felixmanfredi/SmartSprayer/PCB_Sansevero/HermaTech-main/PCB_Rev1/PCB_3D_1.png

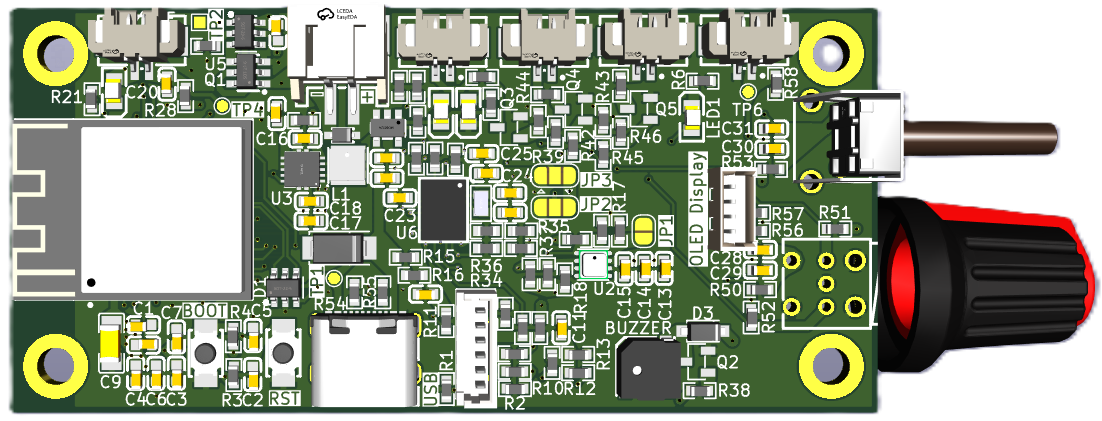
PCB_Sansevero/HermaTech-main/PCB_Rev1/PCB_3D_1.png
