felixmanfredi/SmartSprayer/PCB_Sansevero/HermaTech-main/PCB_Rev1/Anemometer station BOM.xlsx

Descrizione | Quantità | Prezzo c | Link acquisto | Note | Immagine
Anemometro | 1 | 36 | link Amazon (https://www.amazon.it/-/en/gp/product/B086J3R84R/ref=ewc_pr_img_1?smid=AZNIYHVQTVJ7J&psc=1)
ESP32-S3-DevKitC-1 WROOM-1-N16R8 | 1 | 12 | link Amazon (https://www.amazon.it/-/en/ESP-S3-DevKitC-1-WROOM-1-N16R8-Expansion-Development-Bluetooth/dp/B0C6KN35L2) | link Amazon 2 (https://www.amazon.it/-/en/Development-S3-DevKitC-1-WROOM-1-N16R8-Expansion-Compatible/dp/B0DMN5T1GQ)
GPIO expansion board | 1 | 6.15 | link Amazon (https://www.amazon.it/-/en/Joselin-ESP32-S3-Expansion-Breakout-Development/dp/B0D8VKGFWG)
Boost Power Module Battery Charge Protection | 1 | 13 | link Amazon (https://www.amazon.it/-/en/gp/product/B0B9NZ2V5J/ref=ewc_pr_img_1?smid=A3U3NV7MT8POQS&psc=1)
LASER | 1 | 8 | link Amazon (https://www.amazon.it/CESFONJER-Module-Arduino-Raspberry-Prototyping/dp/B07RM3RWSF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)
batteria 1100 mAh | 2 | 10.85 | link Amazon (https://www.amazon.it/Rechargeable-Lithium-Polymer-Battery-Connector/dp/B08FD39Y5R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)
LIDAR TF Luna | 1 | 29 | link Amazon (https://www.amazon.it/youyeetoo-TF-Luna-misurazione-rilevamento-industriale/dp/B088BBJ9SQ)
Lidar VL53L0X | 1 | 4.5 | link Amazon (https://www.amazon.it/-/en/VL53L0X-Distance-GY-VL53L0XV2-Compatible-ARDUINO/dp/B0C3Z4MN6W?s=tools)
