felixmanfredi/SmartSprayer/PCB_Sansevero/HermaTech-main/PCB_Rev1/Knob.step

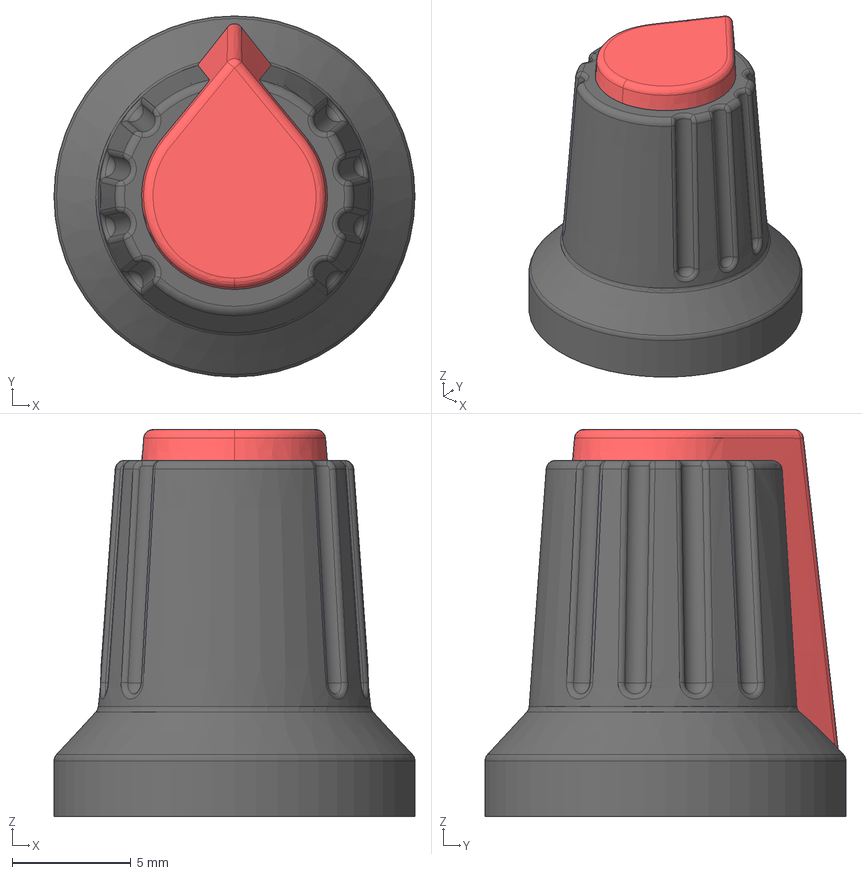
[picture p4: CAD file, 2025-11-18]
PCB_Sansevero/HermaTech-main/PCB_Rev1/Knob.step
15.2 x 15.2 x 16.3 mm
Rouge
Extérieur
