felixmanfredi/SmartSprayer/PCB_Sansevero/HermaTech-main/PCB_Rev1/Schematic_sheets.pdf

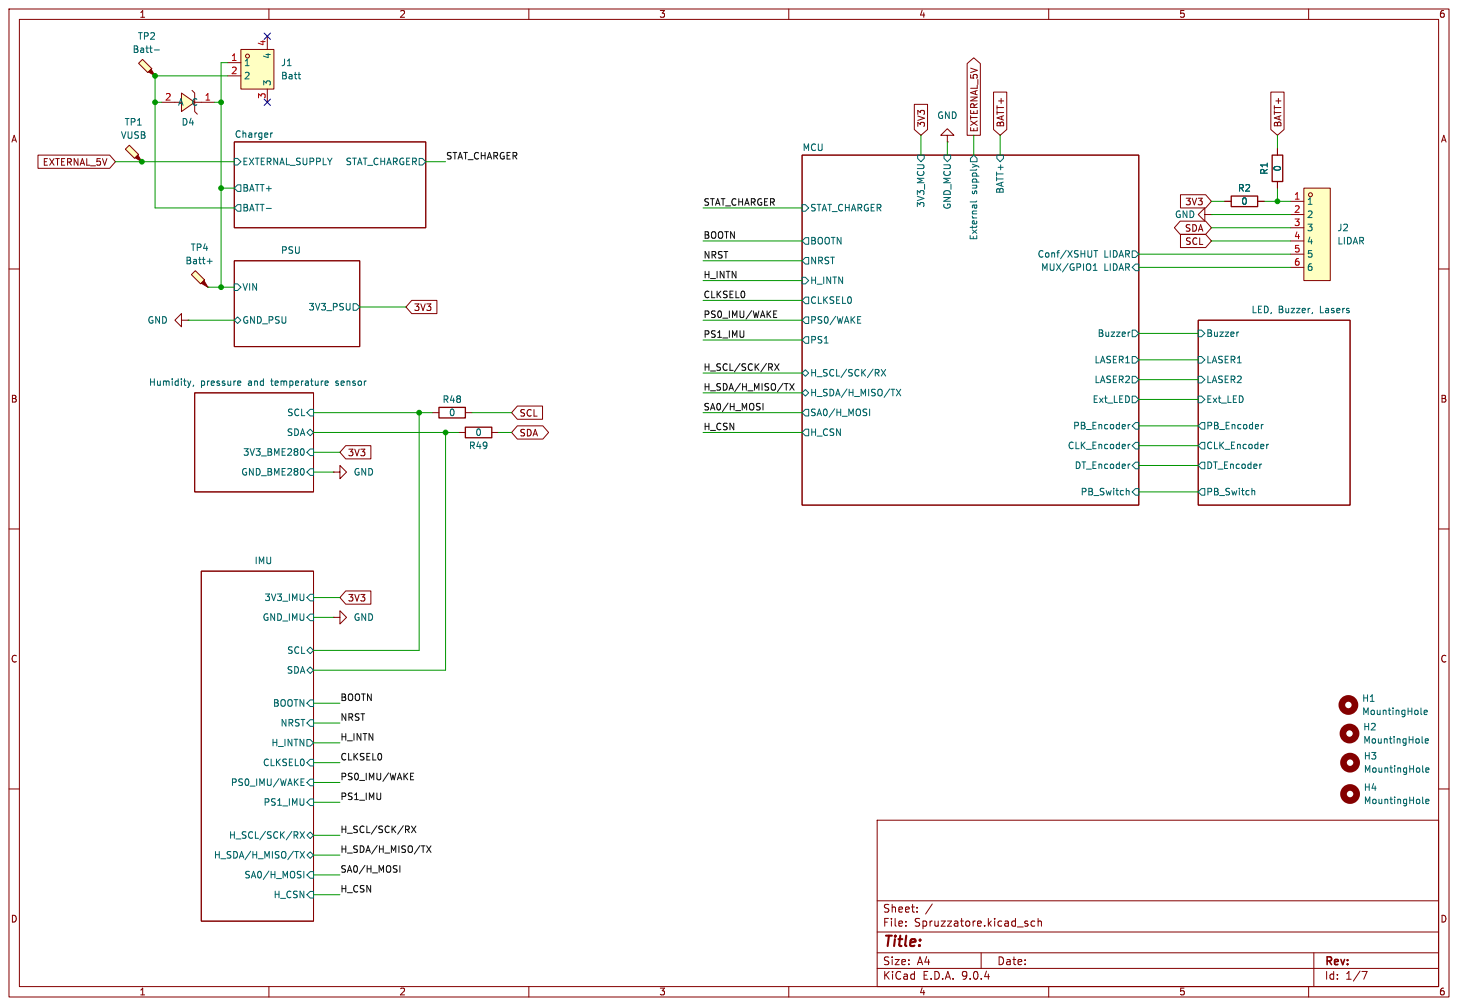
[picture p5: page 1]

IMU
SCL H_SDA/H_MISO/TX CLKSEL0 SA0/H_MOSI H_SCL/SCK/RX H_INTN

Id: 1/7 Title: File: Spruzzatore.kicad_sch Sheet: /

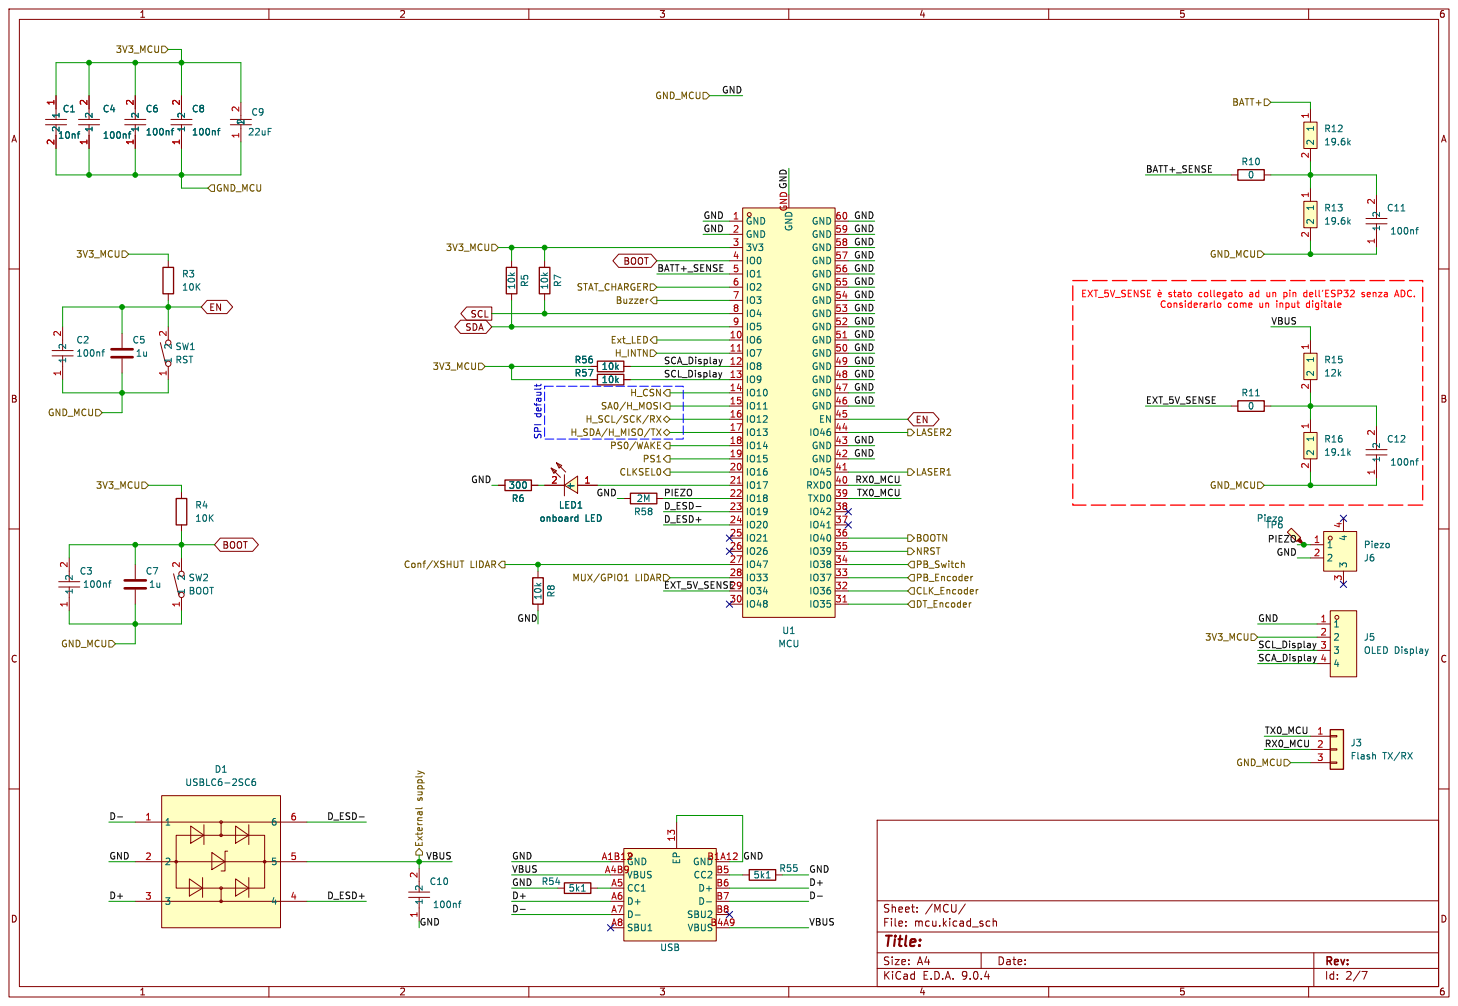
[picture p6: page 2]

Id: 2/7 Title: File: mcu.kicad_sch Sheet: /MCU/

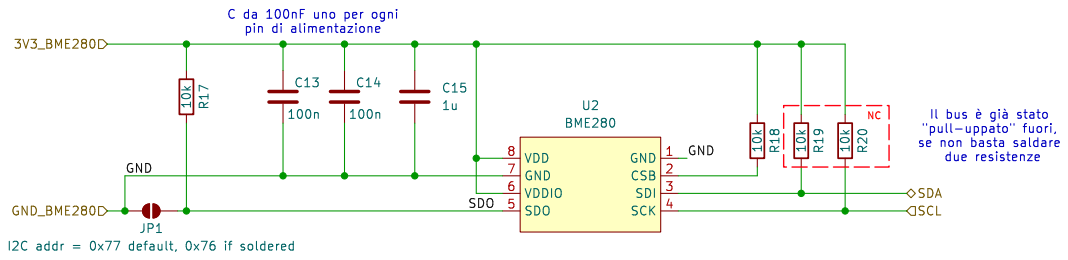
[picture p7: page 3]

C da 100nF uno per ogni

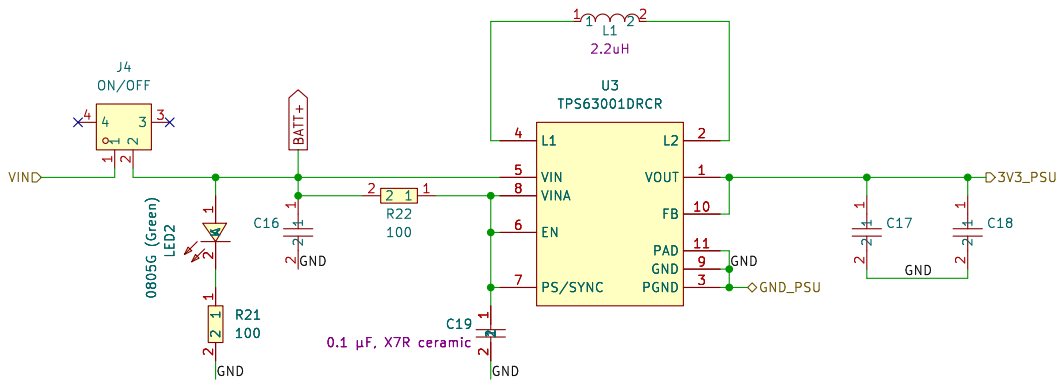
[picture p8: page 4]

Id: 4/7 Title: File: TPS63000_1A_3.3V.kicad_sch Sheet: /PSU/

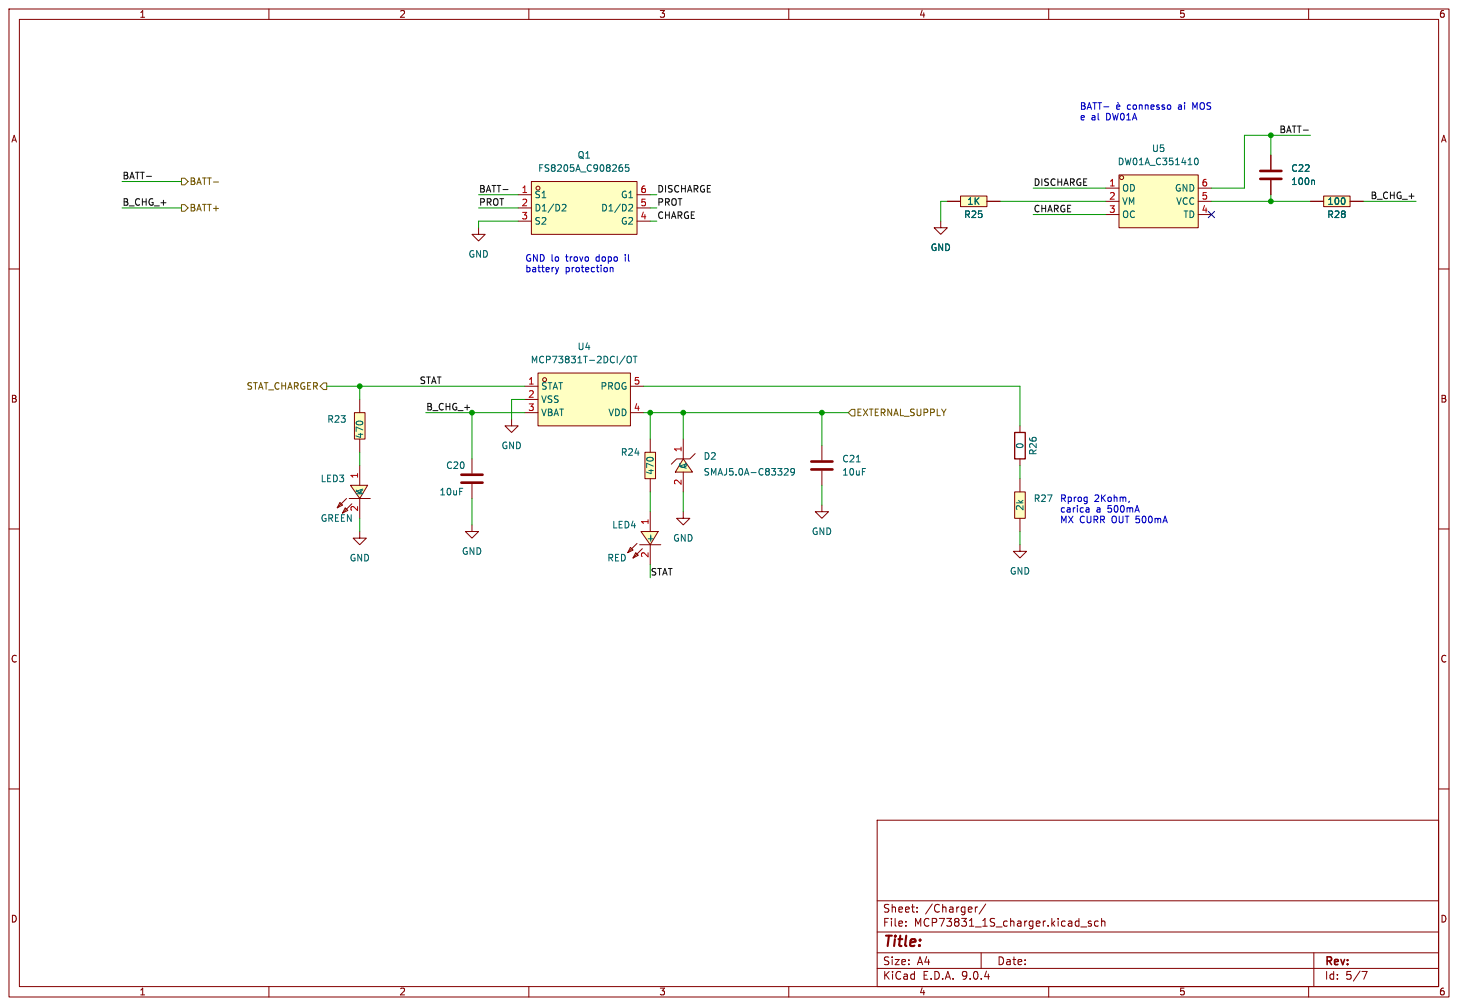
[picture p9: page 5]

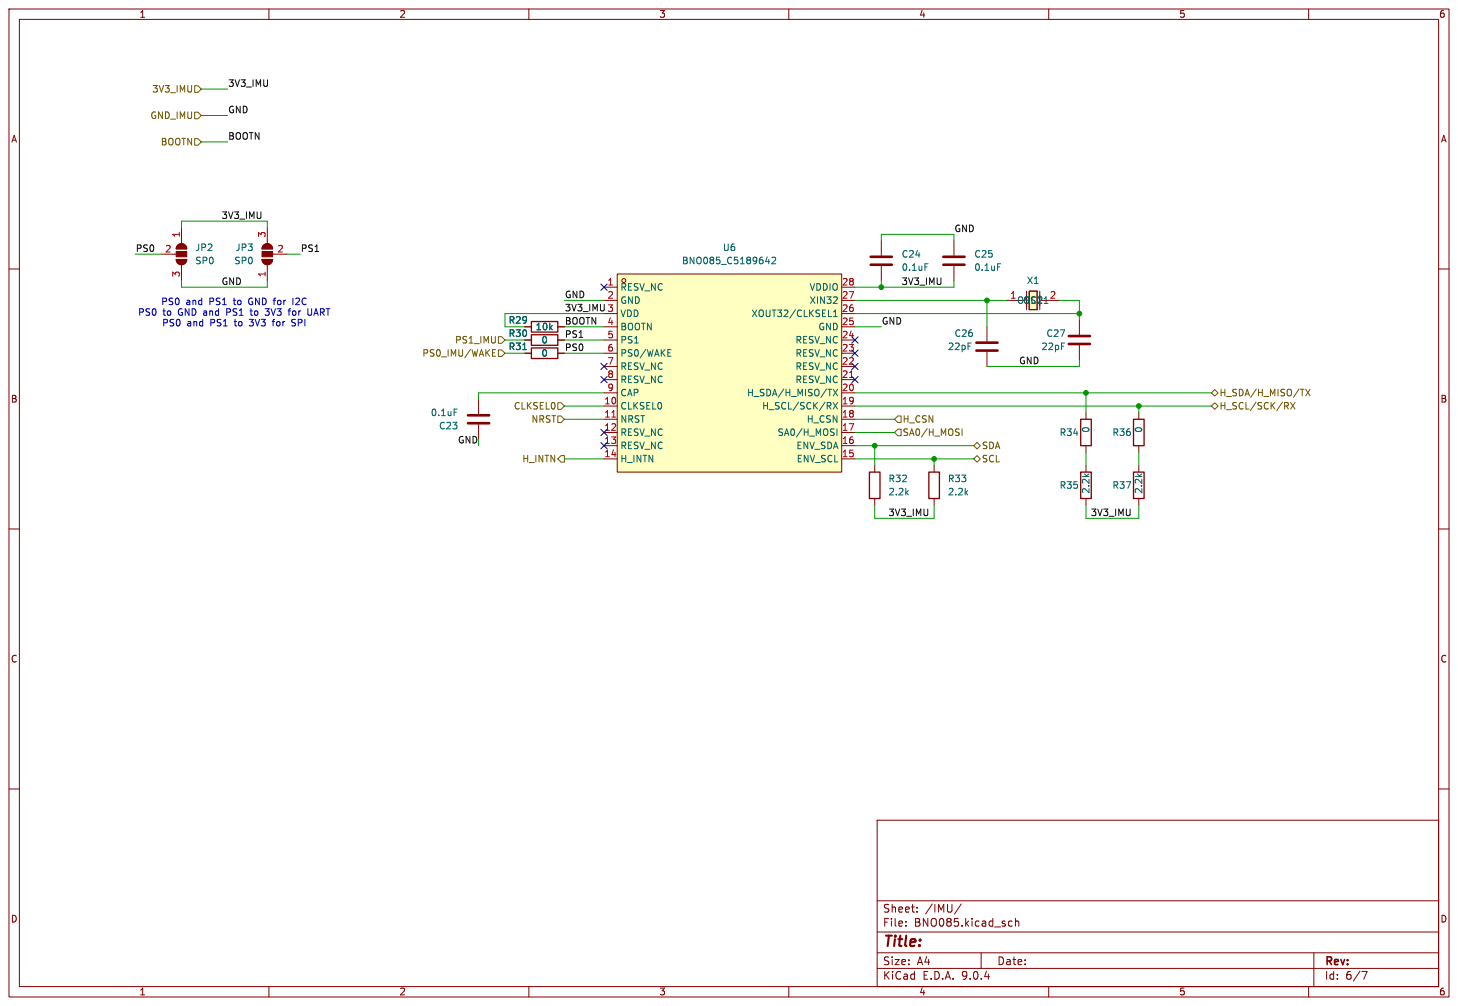
[picture p10: page 6]

PS0 and PS1 to GND for I2C

Id: 6/7 Title: File: BNO085.kicad_sch Sheet: /IMU/

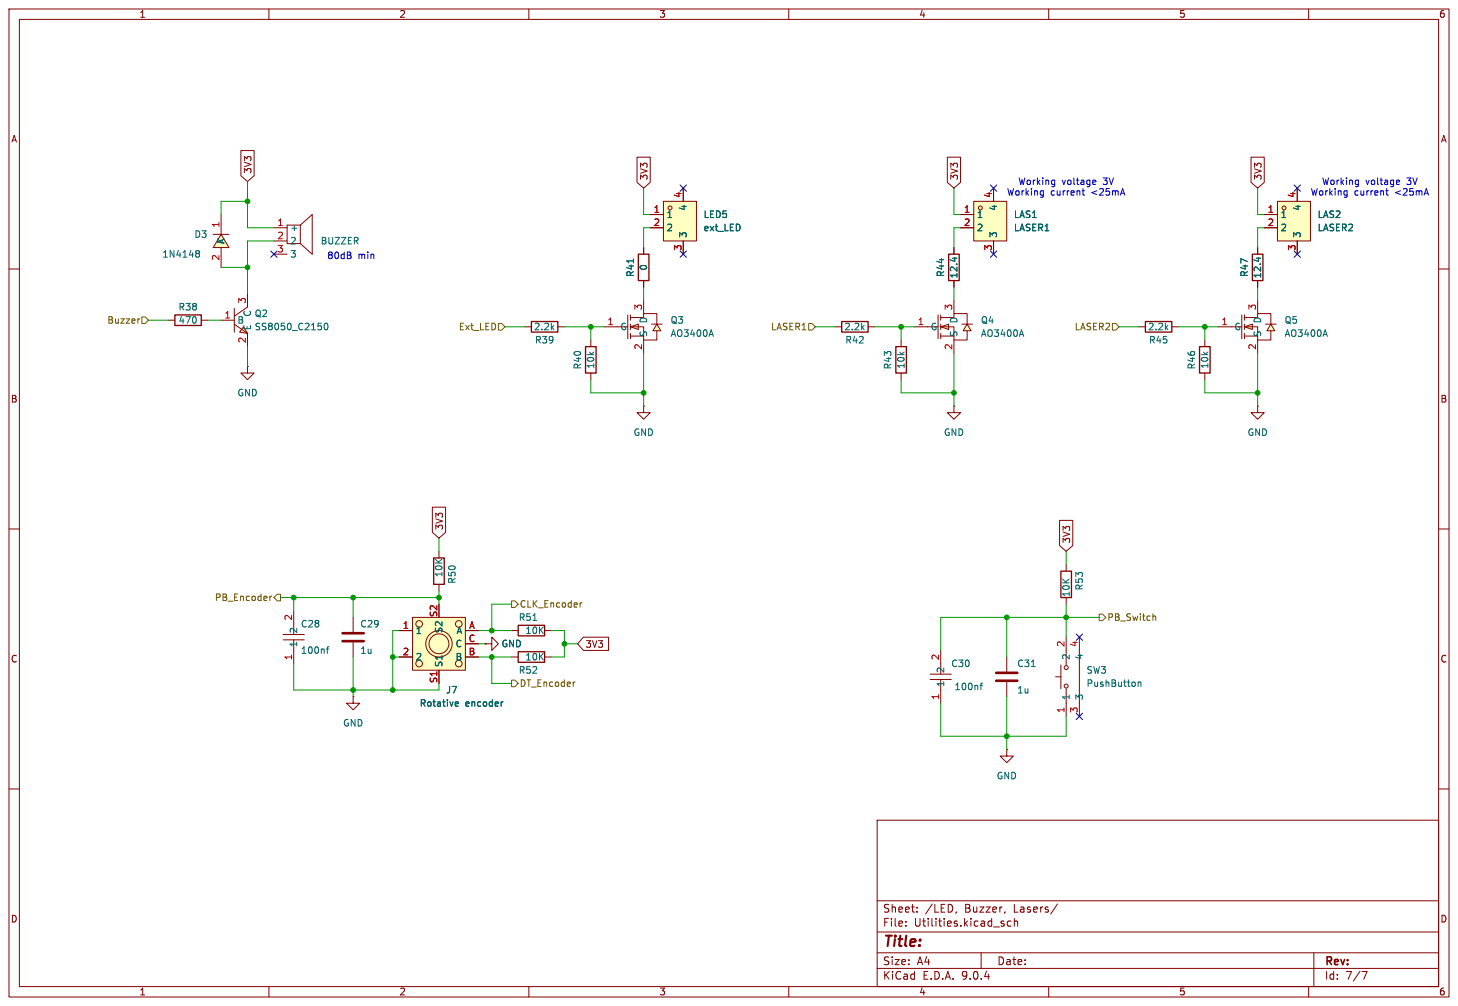
[picture p11: page 7]
