felixmanfredi/SmartSprayer/PCB_Sansevero/HermaTech-main/PCB_Rev1/Spruzzatore.kicad_pcb

## KiCad design PCB_Sansevero/HermaTech-main/PCB_Rev1/Spruzzatore.kicad_pcb (2025-11-18)

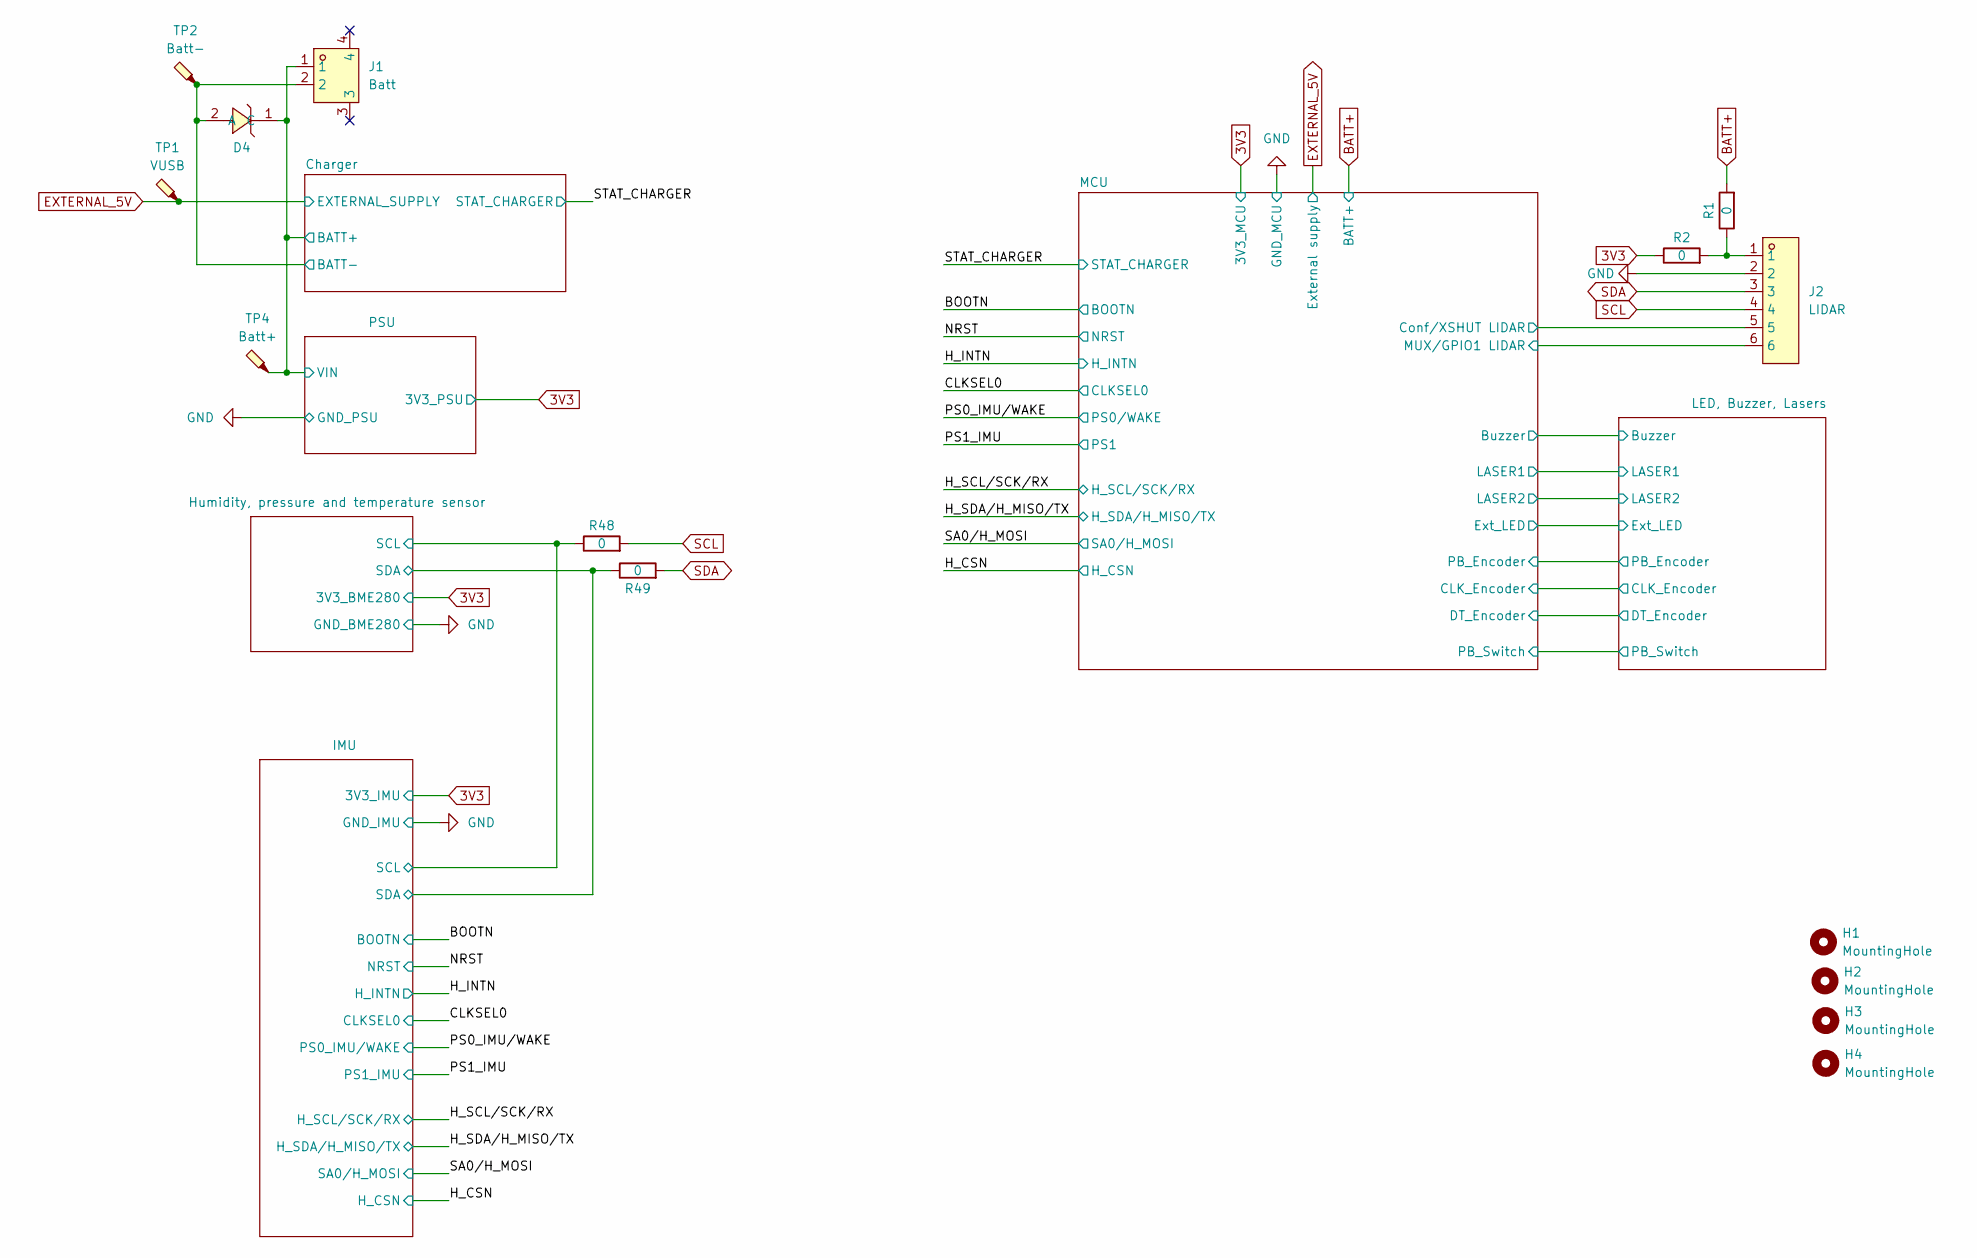
[picture p12: schematic Spruzzatore.kicad_sch]

Parts:
D4: SLESD4V5S; SOD-323_L1.7-W1.3-LS2.6-RD-1; LCSC Part C5155454
H1, H2, H3, H4: MountingHole; MountingHole_3.2mm_M3_DIN965_Pad
J1: Batt; CONN-SMD_P2.00_S2B-PH-SM4-TB-LF-SN; LCSC Part C295747
J2: LIDAR; CONN-TH_6P-P1.25_BX-MX1.25-6PZZ; LCSC Part C22388452
R1, R2, R48, R49: 0; R0603; LCSC Part C21189
TP1: VUSB; TestPoint_Pad_D1.0mm
TP2: Batt-; TestPoint_Pad_1.0x1.0mm
TP4: Batt+; TestPoint_Pad_D1.0mm

Connections:
3V3: R2.1; also elsewhere on the board
/Charger/BATT-: D4.2 (A), J1.2, TP2.1; also elsewhere on the board
/Charger/B_CHG_+: D4.1 (C), J1.1, TP4.1; also elsewhere on the board
/Humidity, pressure and temperature sensor/SCL: R48.1; also elsewhere on the board
/Humidity, pressure and temperature sensor/SDA: R49.1; also elsewhere on the board
/MCU/Conf/XSHUT LIDAR: J2.5; also elsewhere on the board
/MCU/MUX/GPIO1 LIDAR: J2.6; also elsewhere on the board
BATT+: R1.2; also elsewhere on the board
EXTERNAL_5V: TP1.1; also elsewhere on the board
GND: J2.2; also elsewhere on the board
unnamed: J2.1, R1.1, R2.2
SCL: J2.4, R48.2; also elsewhere on the board
SDA: J2.3, R49.2; also elsewhere on the board

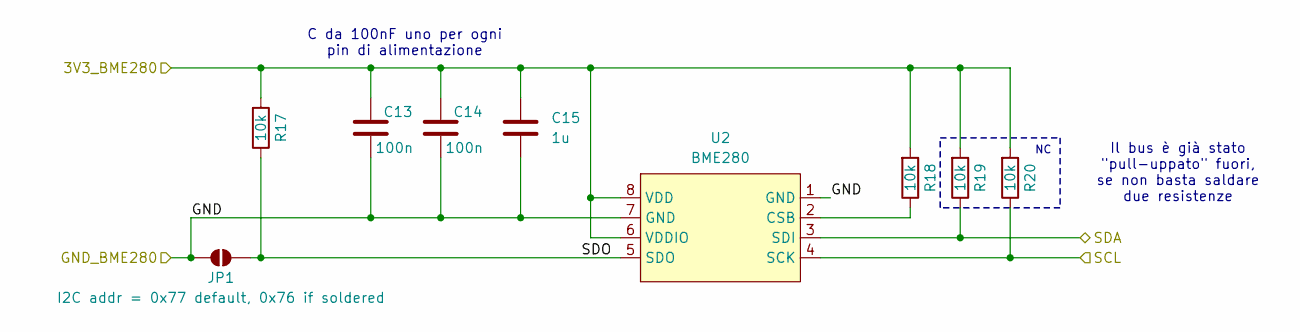
[picture p13: schematic BME280.kicad_sch]

Parts:
C13, C14: 100n; C0603; LCSC Part C14663
C15: 1u; C0603; LCSC Part C15849
JP1: I2C addr = 0x77 default, 0x76 if soldered; SolderJumper-2_P1.3mm_Open_RoundedPad1.0x1.5mm
R17, R18, R19, R20: 10k; R0603; LCSC Part C25804
U2: BME280; LGA-8_BME280_BL; LCSC Part C92489

Connections:
3V3: C13.1, C14.1, C15.1, R17.2, R18.2, R19.2, R20.2, U2.6 (VDDIO), U2.8 (VDD); also elsewhere on the board
/Humidity, pressure and temperature sensor/SCL: R20.1, U2.4 (SCK); also elsewhere on the board
/Humidity, pressure and temperature sensor/SDA: R19.1, U2.3 (SDI); also elsewhere on the board
/Humidity, pressure and temperature sensor/SDO: JP1.1 (A), R17.1, U2.5 (SDO)
GND: C13.2, C14.2, C15.2, JP1.2 (B), U2.1 (GND), U2.7 (GND); also elsewhere on the board
unnamed: R18.1, U2.2 (CSB)

Notes on the sheet:
C da 100nF uno per ogni pin di alimentazione
Il bus è già stato "pull-uppato" fuori, se non basta saldare due resistenze

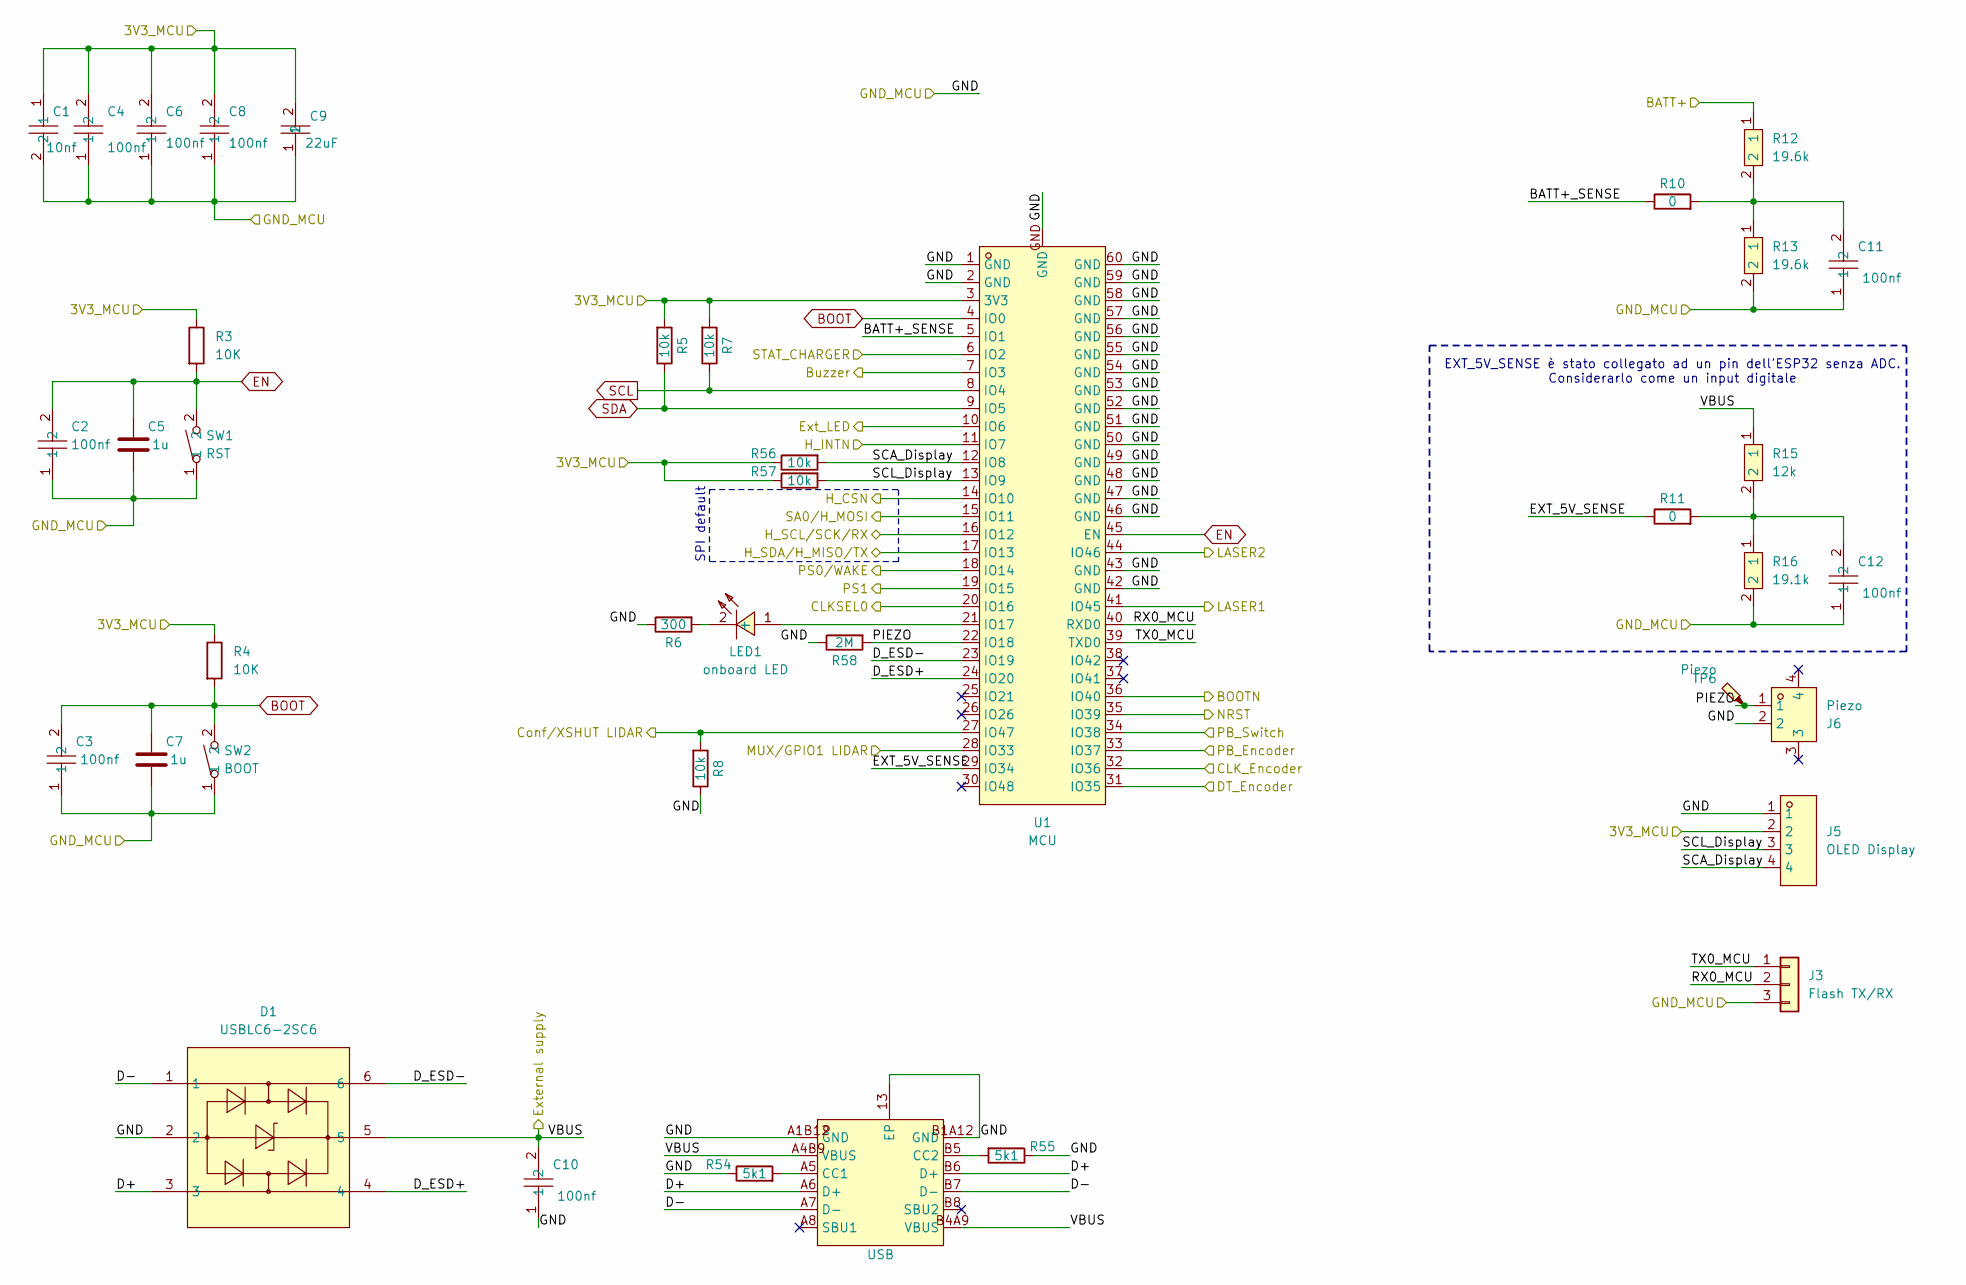
[picture p14: schematic mcu.kicad_sch]

Parts:
C1: 10nf; C0603; LCSC Part C57112
C2, C3, C4, C6, C8, C10, C11, C12: 100nf; C0603; LCSC Part C14663
C5, C7: 1u; C0603; LCSC part C15849
C9: 22uF; C1206; LCSC Part C12891
D1: USBLC6-2SC6; SOT-23-6_L2.9-W1.6-P0.95-LS2.8-BL; LCSC Part C2687116
J3: Flash TX/RX; JST_GH_SM03B-GHS-TB_1x03-1MP_P1.25mm_Horizontal
J5: OLED Display; CONN-TH_4P-P1.25_WAFER-MX1.25-4PZZ; LCSC Part C22390409
J6: Piezo; CONN-SMD_2P-P1.25_XUNPU_WAFER-MX1.25-2PWB; LCSC Part C3029359
LED1: onboard LED; LED0805-R-RD; LCSC Part C84256
R3, R4: 10K; R0603; LCSC Part C25804
R5, R7, R56, R57: 10k; R0603; LCSC Part C25804
R6: 300; R0603; LCSC Part C23025
R8: 10k; R0603
R10, R11: 0; R0603; LCSC Part C21189
R12, R13: 19.6k; R0603; LCSC Part C861185
R15: 12k; R0603; LCSC Part C861185
R16: 19.1k; R0603; LCSC Part C861097
R54, R55: 5k1; R0603; LCSC C23186
R58: 2M; R0603; LCSC Part C23025
SW1: RST; SW-SMD_L3.9-W2.9-P4.15-LS5.0; LCSC Part C493285
SW2: BOOT; SW-SMD_L3.9-W2.9-P4.15-LS5.0; LCSC Part C493285
TP6: Piezo; TestPoint_Pad_D1.0mm
U1: MCU; BULETM-SMD_ESP32-S3-MINI-1-N8; LCSC Part C3013941
USB1: USB; USB-C-SMD_TYPE-C-16P-1; LCSC Part C2982555

Connections:
3V3: C1.1, C4.2, C6.2, C8.2, C9.2, J5.2, R3.1, R4.1, R5.2, R7.2, R56.1, R57.1, U1.3 (3V3); also elsewhere on the board
/BOOTN: U1.36 (IO40); also elsewhere on the board
/CLKSEL0: U1.20 (IO16); also elsewhere on the board
/H_CSN: U1.14 (IO10); also elsewhere on the board
/H_INTN: U1.11 (IO7); also elsewhere on the board
/H_SCL/SCK/RX: U1.16 (IO12); also elsewhere on the board
/H_SDA/H_MISO/TX: U1.17 (IO13); also elsewhere on the board
/LED, Buzzer, Lasers/Buzzer: U1.7 (IO3); also elsewhere on the board
/LED, Buzzer, Lasers/CLK_Encoder: U1.32 (IO36); also elsewhere on the board
/LED, Buzzer, Lasers/DT_Encoder: U1.31 (IO35); also elsewhere on the board
/LED, Buzzer, Lasers/Ext_LED: U1.10 (IO6); also elsewhere on the board
/LED, Buzzer, Lasers/LASER1: U1.41 (IO45); also elsewhere on the board
/LED, Buzzer, Lasers/LASER2: U1.44 (IO46); also elsewhere on the board
/LED, Buzzer, Lasers/PB_Encoder: U1.33 (IO37); also elsewhere on the board
/LED, Buzzer, Lasers/PB_Switch: U1.34 (IO38); also elsewhere on the board
/MCU/BATT+_SENSE: R10.1, U1.5 (IO1)
/MCU/Conf/XSHUT LIDAR: R8.2, U1.27 (IO47); also elsewhere on the board
/MCU/D+: D1.3, USB1.A6 (D+), USB1.B6 (D+)
/MCU/D-: D1.1, USB1.A7 (D-), USB1.B7 (D-)
/MCU/D_ESD+: D1.4, U1.24 (IO20)
/MCU/D_ESD-: D1.6, U1.23 (IO19)
/MCU/EXT_5V_SENSE: R11.1, U1.29 (IO34)
/MCU/MUX/GPIO1 LIDAR: U1.28 (IO33); also elsewhere on the board
/MCU/PIEZO: J6.1, R58.2, TP6.1, U1.22 (IO18)
/MCU/RX0_MCU: J3.2, U1.40 (RXD0)
/MCU/SCA_Display: J5.4, R56.2, U1.12 (IO8)
/MCU/SCL_Display: J5.3, R57.2, U1.13 (IO9)
/MCU/TX0_MCU: J3.1, U1.39 (TXD0)
/NRST: U1.35 (IO39); also elsewhere on the board
/PS0_IMU/WAKE: U1.18 (IO14); also elsewhere on the board
/PS1_IMU: U1.19 (IO15); also elsewhere on the board
/SA0/H_MOSI: U1.15 (IO11); also elsewhere on the board
/STAT_CHARGER: U1.6 (IO2); also elsewhere on the board
BATT+: R12.1; also elsewhere on the board
BOOT: C3.2, C7.1, R4.2, SW2.2, U1.4 (IO0)
EN: C2.2, C5.1, R3.2, SW1.2, U1.45 (EN)
EXTERNAL_5V: C10.2, D1.5, R15.1, USB1.A4B9 (VBUS), USB1.B4A9 (VBUS); also elsewhere on the board
GND: C1.2, C2.1, C3.1, C4.1, C5.2, C6.1, C7.2, C8.1, C9.1, C10.1, C11.1, C12.1, D1.2, J3.3, J5.1, J6.2, R6.1, R8.1, R13.2, R16.2, R54.1, R55.1, R58.1, SW1.1, SW2.1, U1.1 (GND), U1.2 (GND), U1.42 (GND), U1.43 (GND), U1.46 (GND), U1.47 (GND), U1.48 (GND), U1.49 (GND), U1.50 (GND), U1.51 (GND), U1.52 (GND), U1.53 (GND), U1.54 (GND), U1.55 (GND), U1.56 (GND), U1.57 (GND), U1.58 (GND), U1.59 (GND), U1.60 (GND), U1.GND, USB1.13 (EP), USB1.A1B12 (GND), USB1.B1A12 (GND); also elsewhere on the board
unnamed: C11.2, R10.2, R12.2, R13.1
unnamed: C12.2, R11.2, R15.2, R16.1
unnamed: LED1.1 (+), U1.21 (IO17)
unnamed: LED1.2 (-), R6.2
unnamed: R54.2, USB1.A5 (CC1)
unnamed: R55.2, USB1.B5 (CC2)
SCL: R7.1, U1.8 (IO4); also elsewhere on the board
SDA: R5.1, U1.9 (IO5); also elsewhere on the board

Notes on the sheet:
SPI default
EXT_5V_SENSE è stato collegato ad un pin dell'ESP32 senza ADC. Considerarlo come un input digitale

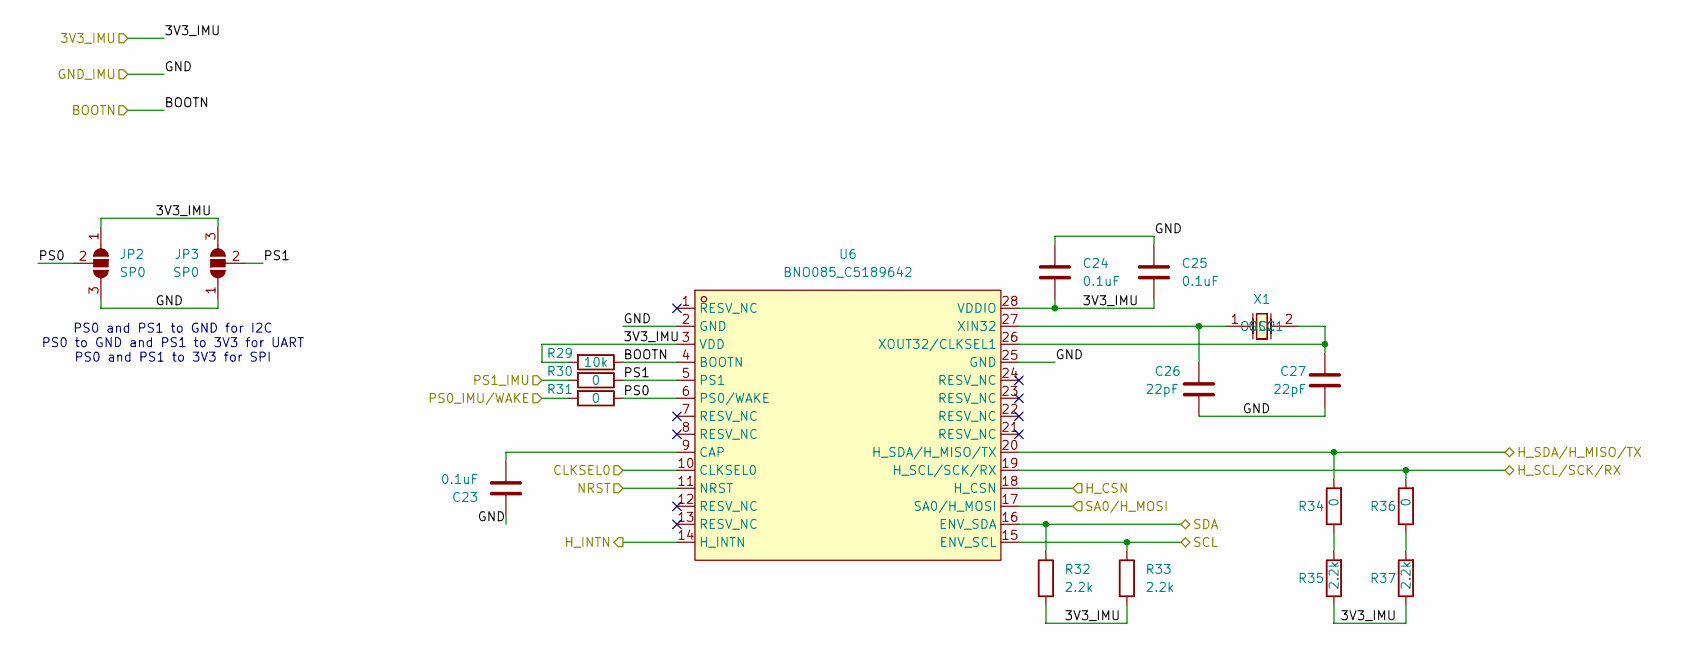
[picture p15: schematic BNO085.kicad_sch]

Parts:
C23, C24, C25: 0.1uF; C0603
C26, C27: 22pF; C0603
JP2, JP3: SP0; SolderJumper-3_P1.3mm_Open_RoundedPad1.0x1.5mm
R29: 10k; R0603; LCSC Part C21189
R30, R31: 0; R0603; LCSC Part C21189
R32, R33, R35, R37: 2.2k; R0603
R34, R36: 0; R0603
U6: BNO085_C5189642; LGA-28_L5.2-W3.8-P0.50-BL; LCSC Part C5189642
X1: ABS06-32.768KHZ-T; OSC-SMD_L2.0-W1.2; LCSC Part C276423

Connections:
3V3: C24.2, C25.2, JP2.1 (A), JP3.3 (B), R29.2, R32.2, R33.2, R35.1, R37.1, U6.3 (VDD), U6.28 (VDDIO); also elsewhere on the board
/BOOTN: R29.1, U6.4 (BOOTN); also elsewhere on the board
/CLKSEL0: U6.10 (CLKSEL0); also elsewhere on the board
/H_CSN: U6.18 (H_CSN); also elsewhere on the board
/H_INTN: U6.14 (H_INTN); also elsewhere on the board
/H_SCL/SCK/RX: R36.2, U6.19 (H_SCL/SCK/RX); also elsewhere on the board
/H_SDA/H_MISO/TX: R34.2, U6.20 (H_SDA/H_MISO/TX); also elsewhere on the board
/Humidity, pressure and temperature sensor/SCL: R33.1, U6.15 (ENV_SCL); also elsewhere on the board
/Humidity, pressure and temperature sensor/SDA: R32.1, U6.16 (ENV_SDA); also elsewhere on the board
/IMU/PS0: JP2.2 (C), R31.1, U6.6 (PS0/WAKE)
/IMU/PS1: JP3.2 (C), R30.1, U6.5 (PS1)
/NRST: U6.11 (NRST); also elsewhere on the board
/PS0_IMU/WAKE: R31.2; also elsewhere on the board
/PS1_IMU: R30.2; also elsewhere on the board
/SA0/H_MOSI: U6.17 (SA0/H_MOSI); also elsewhere on the board
GND: C23.1, C24.1, C25.1, C26.1, C27.1, JP2.3 (B), JP3.1 (A), U6.2 (GND), U6.25 (GND); also elsewhere on the board
unnamed: R34.1, R35.2
unnamed: R36.1, R37.2
unnamed: C23.2, U6.9 (CAP)
unnamed: C26.2, U6.27 (XIN32), X1.1 (OSC1)
unnamed: C27.2, U6.26 (XOUT32/CLKSEL1), X1.2 (OSC2)

Notes on the sheet:
PS0 and PS1 to GND for I2C PS0 to GND and PS1 to 3V3 for UART PS0 and PS1 to 3V3 for SPI

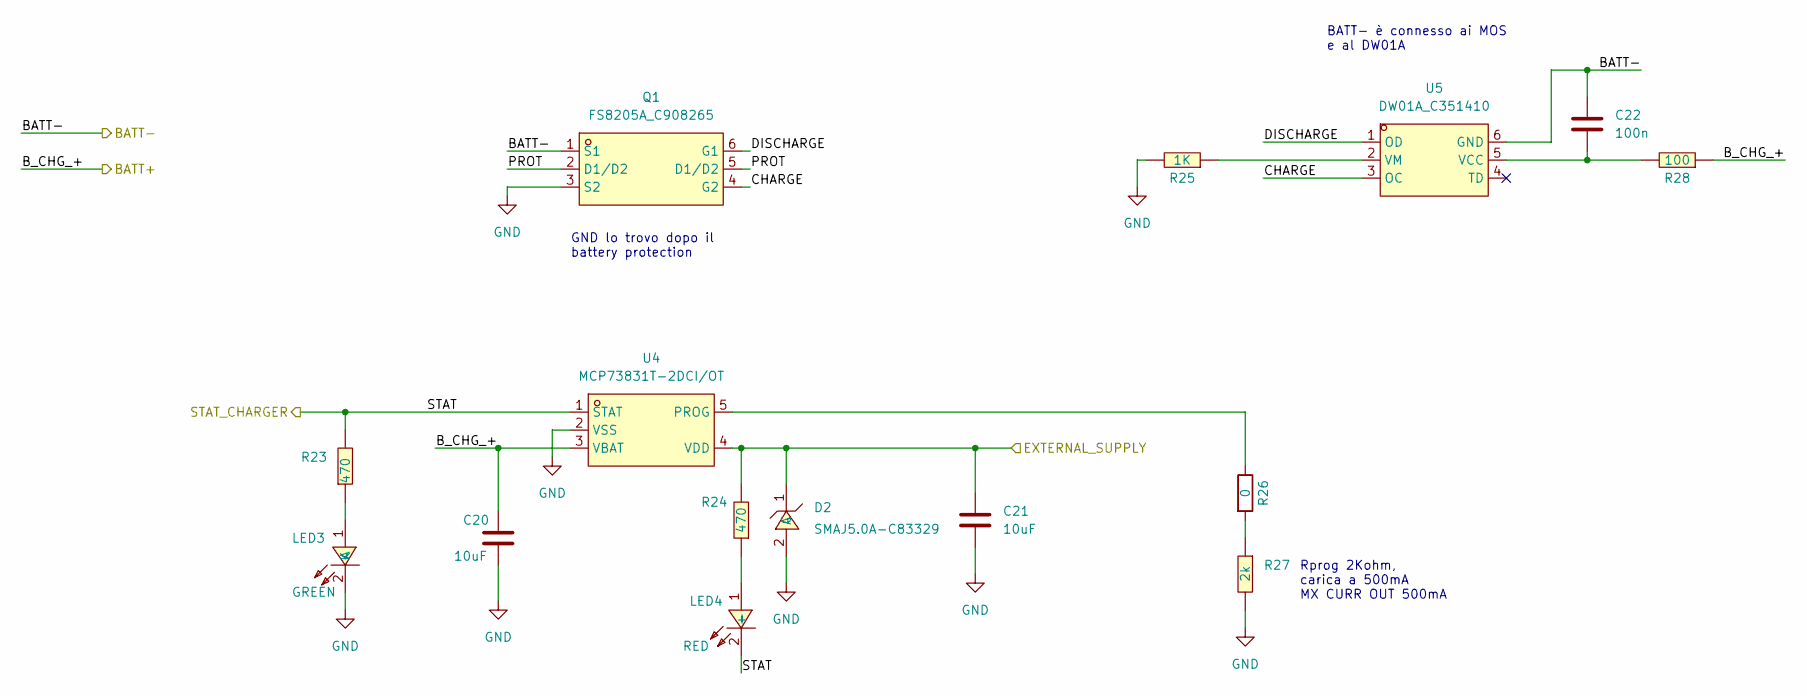
[picture p16: schematic MCP73831_1S_charger.kicad_sch]

Parts:
C20, C21: 10uF; C0603
C22: 100n; C0603
D2: SMAJ5.0A-C83329; SMA_L4.3-W2.6-LS5.2-RD; LCSC Part C83329
LED3: GREEN; LED0805-R-RD; LCSC Part C2297
LED4: RED; LED0805-R-RD; LCSC Part C84256
Q1: FS8205A_C908265; SOT-23-6_L2.9-W1.6-P0.95-LS2.8-BR; LCSC Part C908265
R23, R24: 470; R0603
R25: 1K; R0603
R26: 0; R0603; LCSC Part C21189
R27: 2k; R0603
R28: 100; R0603
U4: MCP73831T-2DCI/OT; SOT-23-5_L2.9-W1.6-P0.95-LS2.8-BL; LCSC Part C625597
U5: DW01A_C351410; SOT-23-6_L2.9-W1.6-P0.95-LS2.8-BL; LCSC Part C351410

Connections:
/Charger/BATT-: C22.1, Q1.1 (S1), U5.6 (GND); also elsewhere on the board
/Charger/B_CHG_+: C20.1, R28.1, U4.3 (VBAT); also elsewhere on the board
/Charger/CHARGE: Q1.4 (G2), U5.3 (OC)
/Charger/DISCHARGE: Q1.6 (G1), U5.1 (OD)
/Charger/PROT: Q1.2 (D1/D2), Q1.5 (D1/D2)
/STAT_CHARGER: LED4.2 (-), R23.2, U4.1 (STAT); also elsewhere on the board
EXTERNAL_5V: C21.1, D2.1 (C), R24.2, U4.4 (VDD); also elsewhere on the board
GND: C20.2, C21.2, D2.2 (A), LED3.2 (K), Q1.3 (S2), R25.2, R27.2, U4.2 (VSS); also elsewhere on the board
unnamed: LED3.1 (A), R23.1
unnamed: LED4.1 (+), R24.1
unnamed: R26.2, R27.1
unnamed: R26.1, U4.5 (PROG)
unnamed: C22.2, R28.2, U5.5 (VCC)
unnamed: R25.1, U5.2 (VM)

Notes on the sheet:
Rprog 2Kohm, carica a 500mA MX CURR OUT 500mA
GND lo trovo dopo il battery protection
BATT- è connesso ai MOS e al DW01A

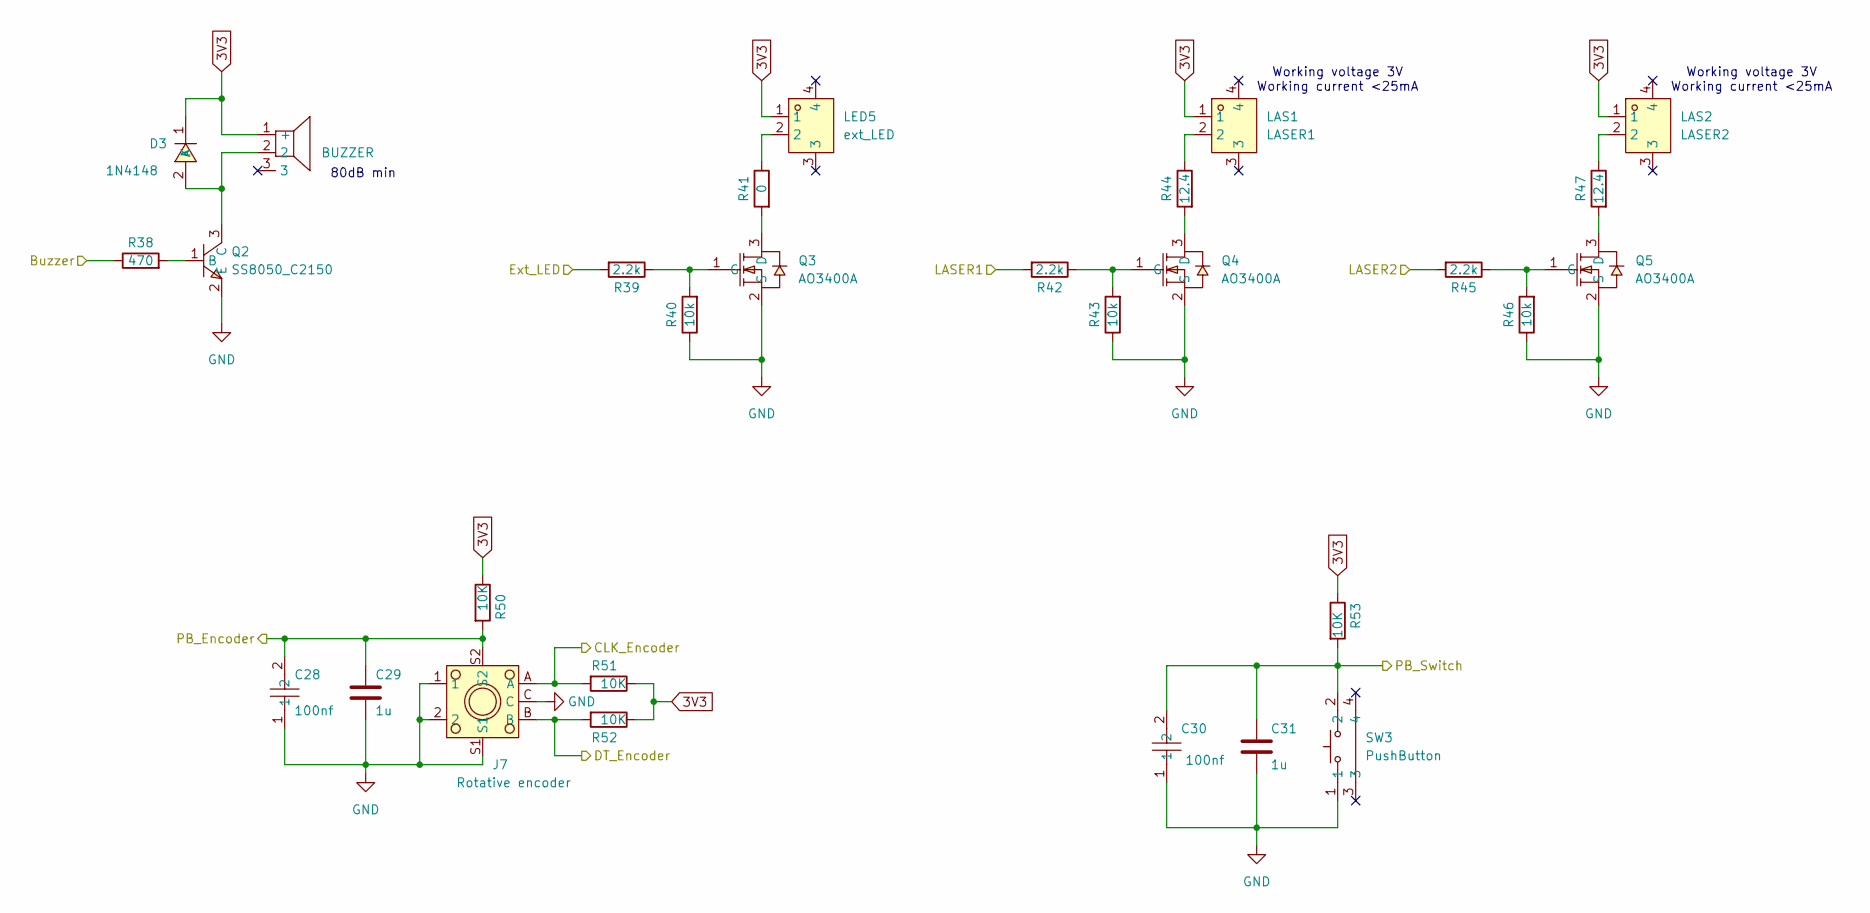
[picture p17: schematic Utilities.kicad_sch]

Parts:
BUZZER1: BUZZER; BUZ-SMD_FST-5025; LCSC Part C391030
C28, C30: 100nf; C0603; LCSC Part C14663
C29, C31: 1u; C0603; LCSC part C15849
D3: 1N4148; SOD-123F_L2.7-W1.6-LS3.8-RD; LCSC Part C81598
J7: Rotative encoder; SW-TH_CTR_ED08905M-FE15C7.0-C10-2053; LCSC Part C18213469
LAS1: LASER1; CONN-SMD_2P-P1.25_XUNPU_WAFER-MX1.25-2PWB; LCSC Part C3029359
LAS2: LASER2; CONN-SMD_2P-P1.25_XUNPU_WAFER-MX1.25-2PWB; LCSC Part C3029359
LED5: ext_LED; CONN-SMD_2P-P1.25_XUNPU_WAFER-MX1.25-2PWB; LCSC Part C3029359
Q2: SS8050_C2150; SOT-23-3_L2.9-W1.3-P1.90-LS2.4-BR; LCSC Part C2150
Q3, Q4, Q5: AO3400A; SOT-23-3_L2.9-W1.3-P1.90-LS2.4-BR; LCSC Part C20917
R38: 470; R0603; LCSC C441919
R39, R42, R45: 2.2k; R0603; LCSC Part C4190
R40, R43, R46: 10k; R0603; LCSC Part C25804
R41: 0; R0603; LCSC Part C17888
R44, R47: 12.4; R0603; LCSC Part C22786
R50, R51, R52, R53: 10K; R0603; LCSC Part C25804
SW3: PushButton; SW-TH_SKHHNJA010; LCSC Part C470264

Connections:
3V3: BUZZER1.1 (+), D3.1 (K), LAS1.1, LAS2.1, LED5.1, R50.1, R51.1, R52.1, R53.1; also elsewhere on the board
/LED, Buzzer, Lasers/Buzzer: R38.1; also elsewhere on the board
/LED, Buzzer, Lasers/CLK_Encoder: J7.A, R51.2; also elsewhere on the board
/LED, Buzzer, Lasers/DT_Encoder: J7.B, R52.2; also elsewhere on the board
/LED, Buzzer, Lasers/Ext_LED: R39.2; also elsewhere on the board
/LED, Buzzer, Lasers/LASER1: R42.2; also elsewhere on the board
/LED, Buzzer, Lasers/LASER2: R45.2; also elsewhere on the board
/LED, Buzzer, Lasers/PB_Encoder: C28.2, C29.1, J7.S2, R50.2; also elsewhere on the board
/LED, Buzzer, Lasers/PB_Switch: C30.2, C31.1, R53.2, SW3.2; also elsewhere on the board
GND: C28.1, C29.2, C30.1, C31.2, J7.1, J7.2, J7.C, J7.S1, Q2.2 (E), Q3.2 (S), Q4.2 (S), Q5.2 (S), R40.1, R43.1, R46.1, SW3.1; also elsewhere on the board
unnamed: BUZZER1.2, D3.2 (A), Q2.3 (C)
unnamed: LAS1.2, R44.1
unnamed: LAS2.2, R47.1
unnamed: LED5.2, R41.1
unnamed: Q2.1 (B), R38.2
unnamed: Q3.3 (D), R41.2
unnamed: Q3.1 (G), R39.1, R40.2
unnamed: Q4.3 (D), R44.2
unnamed: Q4.1 (G), R42.1, R43.2
unnamed: Q5.3 (D), R47.2
unnamed: Q5.1 (G), R45.1, R46.2

Notes on the sheet:
Working voltage 3V Working current <25mA
80dB min

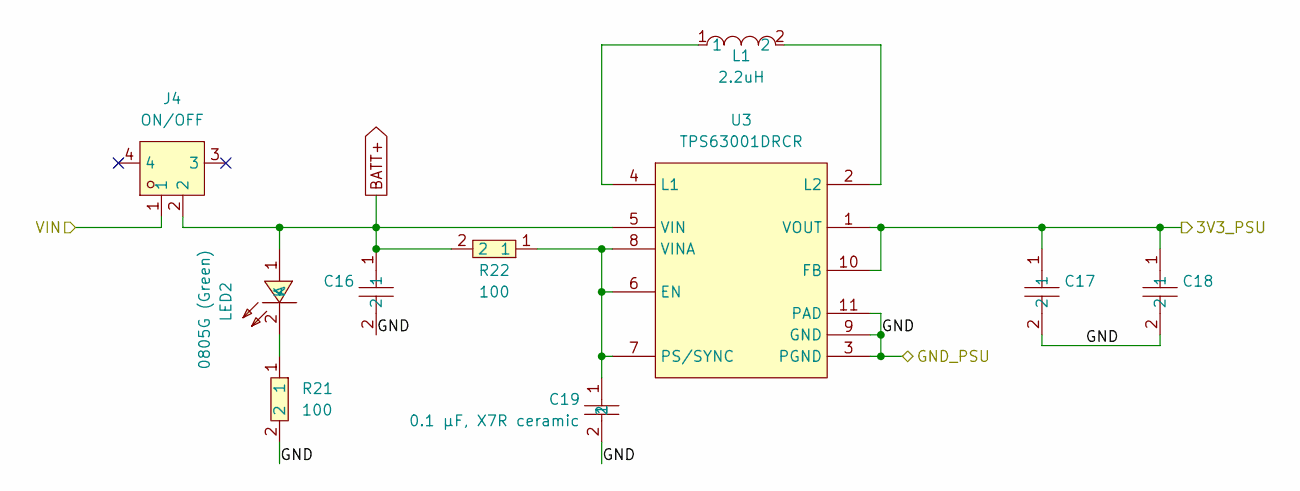
[picture p18: schematic TPS63000_1A_3.3V.kicad_sch]

Parts:
C16, C17, C18: CL10B106MQ8NRNC; C0603; LCSC Part C3039698
C19: CL10B104KA8NNNC; C0603; LCSC Part C1590
J4: ON/OFF; CONN-SMD_2P-P1.25_XUNPU_WAFER-MX1.25-2PWB; LCSC Part C3029359
L1: LQH3NPN2R2MMEL; IND-SMD_L3.0-W3.0_LQH3NPN2R2NG0L; LCSC Part C668451
LED2: 0805G (Green); LED0805-R-RD; LCSC Part C2297
R21, R22: 100; R0603; LCSC Part C22775
U3: TPS63001DRCR; VSON-10_L3.0-W3.0-P0.50-TL-EP_TPS62410DRCR; LCSC Part C28060

Connections:
3V3: C17.1, C18.1, U3.1 (VOUT), U3.10 (FB); also elsewhere on the board
/Charger/B_CHG_+: J4.1; also elsewhere on the board
BATT+: C16.1, J4.2, LED2.1 (A), R22.2, U3.5 (VIN); also elsewhere on the board
GND: C16.2, C17.2, C18.2, C19.2, R21.2, U3.3 (PGND), U3.9 (GND), U3.11 (PAD); also elsewhere on the board
unnamed: LED2.2 (K), R21.1
unnamed: C19.1, R22.1, U3.6 (EN), U3.7 (PS/SYNC), U3.8 (VINA)
unnamed: L1.1, U3.4 (L1)
unnamed: L1.2, U3.2 (L2)

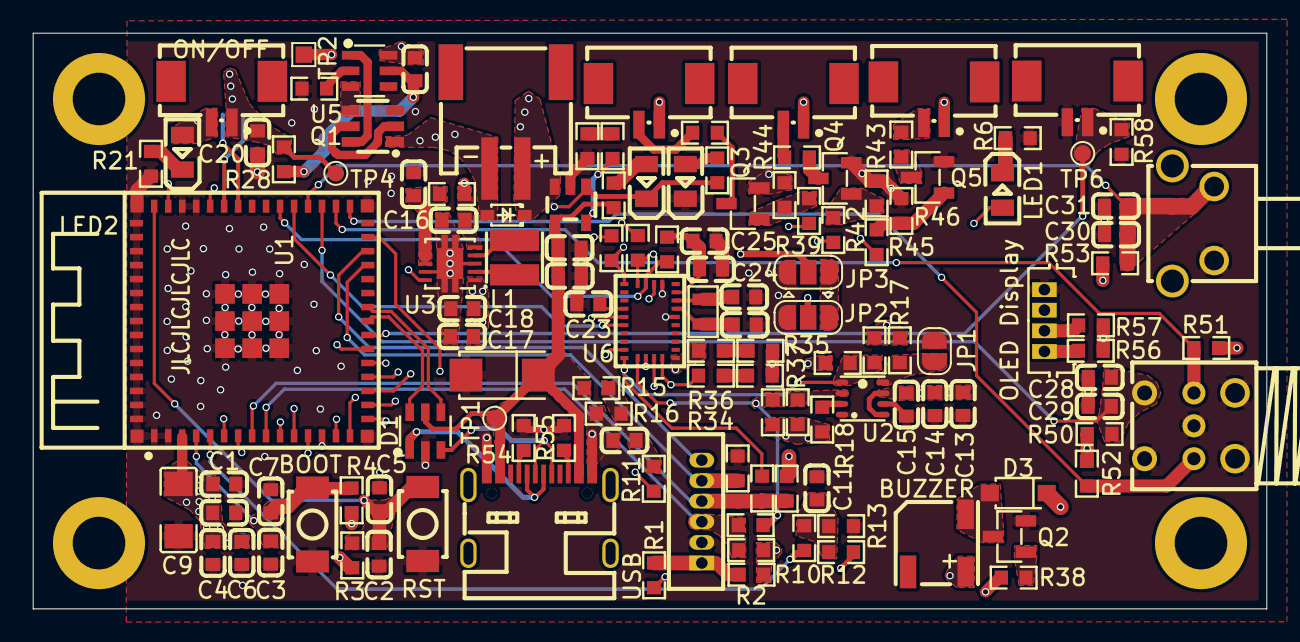
[picture p19: board Spruzzatore.kicad_pcb from above]

Board: 4 copper layers, 75.0 x 35.0 mm, 134 parts (1 on the bottom side), 84 nets.
