felixmanfredi/SmartSprayer/Spruzzatore_v3/include/config.h

#define BATT_SENSE 1 
#define EXT_5V_SENSE 34 
#define BUZZER 3 
#define ONBOARD_LED 17 
#define LASER_1 45 
#define LASER_2 46 
#define EXT_LED 6 

#define DT_ENCODER 35 
#define CLK_ENCODER 36 
#define PB_ENCODER 37 

#define PB_SWITCH 38 

#define SCL_I2C 4 
#define SDA_I2C 5 

#define MUX_LIDAR 33 
#define CONF_LIDAR 47 

#define PIEZO_SENSOR 18 

#define SCA_OLED 8 
#define SCLA_OLED 9 
#define SCREEN_WIDTH 128 
#define SCREEN_HEIGHT 64 

// UUID standard (definiti dal Bluetooth SIG)
#define UUID_SERVICE_DEVICE_INFO  0x180A
#define UUID_CHAR_SERIAL_NUMBER   0x2A25
#define UUID_SERVICE_BATTERY      0x180F
#define UUID_CHAR_BATTERY_LEVEL   0x2A19
